jonelay/chibi-ecen-bldc/design-source/simulation/LT3840_DC1909A_TA01A.asc

C1: cap; 1µ
C2: cap; 4.7µ
C3: cap; 1µ
C4: polcap; 112µ; V=63 Irms=4.8 Rser=0.011
C5: cap; 100p
C6: cap; 13.2µ; V=100 Irms=6.893 Rser=0.002
C7: cap; 2.2n
C8: cap; 44µ; V=6.3 Irms=0 Rser=0.0004 Lser=0
C9: cap; 1n; V=50 Rser=0.002
C10: cap; 10n
C11: cap; 2.2n; V=50 Rser=0.002
C12: cap; 1n; V=50 Rser=0.002
C13: polcap; 680µ; V=6.3 Irms=4.8 Rser=0.012 Lser=0 mfg="KEMET" pn="T510E687K006AS4115" type="Tantalum"
C14: polcap; 680µ; V=6.3 Rser=0.012 Lser=0
C16: cap; 10n
D1: diode
L1: ind; 2.2µ; Ipk=31.9 Rser=0.0023 Cpar=0
L2: ind; 33µ; Ipk=0.6 Rser=1.0922 Rpar=3108.6 Cpar=0 mfg="Coilcraft" pn="ME3220-333"
M1: nmos; BSC123N08NS3
M2: nmos; BSC042NE7NS3
R1: res; 105K
R2: res; 13K
R3: res; 1K
R4: res; 100K
R5: res; 2.5m
R6: res; 0.167
R7: res; 825K
R8: res; 12
R9: res; 12
R10: res; 499K
R12: res; 1Meg
R13: res; 1Meg
U2: LT3840
V1: voltage; 12
Named nets: 0, IN, OUT
.tran 2.5m startup
LT3840 - Wide Input Range Synchronous Regulator Controller with Accurate Current Limit
High Efficiency Synchronous Buck Converter
Input: 4.5V to 60V       Output: 3.3V @ 20A, Fsw = 150kHz
Note:
  If the simulation model is not found please update with the "Sync Release" command from the "Tools" menu.
  It remains the customer's responsibility to verify proper and reliable operation in the actual application.
  Component substitution and printed circuit board layout may significantly affect circuit performance or reliability.
  Contact your local sales representative for assistance. This circuit is distributed to customers only for use with LTC parts.
  Copyright © 2014 Linear Technology Inc. All rights reserved.
(150kHz)
