jonelay/chibi-ecen-bldc/(list of files, drawings)

Other design files:
design-source/xdx/pcb/Layout/LayoutDB.lyt
gerbers/Gerber/Board1.dsn
