jonelay/chibi-ecen-bldc/design-source/cubemx/chibibldc_v02.ioc

Mcu.UserName=STM32F405RGTx
PA0-WKUP.GPIO_Label=ADC_VOLT3
PA0-WKUP.Signal=ADCx_IN0
PA1.GPIO_Label=ADC_VOLT2
PA1.Signal=ADCx_IN1
PA10.GPIO_Label=H1
PA10.Signal=S_TIM1_CH3
PA11.GPIO_Label=USB_DM
PA11.Signal=USB_OTG_FS_DM
PA12.GPIO_Label=USB_DP
PA12.Signal=USB_OTG_FS_DP
PA13.GPIO_Label=SWDIO
PA13.Signal=SYS_JTMS-SWDIO
PA14.GPIO_Label=SWCLK
PA14.Signal=SYS_JTCK-SWCLK
PA2.GPIO_Label=ADC_VOLT1
PA2.Signal=ADCx_IN2
PA4.GPIO_Label=ADC_TEMP
PA4.Signal=ADCx_IN4
PA5.GPIO_Label=ADC_CURRENT2
PA5.Signal=ADCx_IN5
PA6.GPIO_Label=ADC_CURRENT1
PA6.Signal=ADCx_IN6
PA7.GPIO_Label=LED_RED
PA7.Signal=GPIO_Output
PA8.GPIO_Label=H3
PA8.Signal=S_TIM1_CH1
PA9.GPIO_Label=H2
PA9.Signal=S_TIM1_CH2
PB10.GPIO_Label=RX_SCL
PB10.Signal=USART3_TX
PB11.GPIO_Label=TX_SDA
PB11.Signal=USART3_RX
PB12.GPIO_Label=DC_CAL
PB12.Signal=GPIO_Output
PB13.GPIO_Label=L3
PB13.Signal=TIM1_CH1N
PB14.GPIO_Label=L2
PB14.Signal=TIM1_CH2N
PB15.GPIO_Label=L1
PB15.Signal=TIM1_CH3N
PB5.GPIO_Label=SERVO
PB5.Signal=GPIO_Analog
PB6.GPIO_Label=HALL1
PB6.Signal=S_TIM4_CH1
PB7.GPIO_Label=HALL2
PB7.Signal=S_TIM4_CH2
PB8.Signal=CAN1_RX
PB9.GPIO_Label=CAN_TX
PB9.Signal=CAN1_TX
PC0.Signal=ADCx_IN10
PC10.GPIO_Label=EN_GATE
PC10.Signal=GPIO_Output
PC11.GPIO_Label=HALL_3
PC11.Signal=GPIO_Input
PC12.GPIO_Label=FAULT
PC12.Signal=GPIO_Output
PC2.Signal=ADCx_IN12
PC3.Signal=GPIO_Input
PC5.GPIO_Label=ADC_EXT
PC5.Signal=GPIO_Output
PC6.GPIO_Label=TX_SDA
PC6.Signal=I2S2_MCK
PC7.GPIO_Label=RX_SCL
PC7.Signal=I2S3_MCK
PH0-OSC_IN.Signal=RCC_OSC_IN
PH1-OSC_OUT.Signal=RCC_OSC_OUT
