jonelay/chibi-ecen-bldc/(commit log)

2026-01-08 Initial commit: Chibi-ECEN-BLDC hardware project
    [Board1.dsn, LayoutDB.lyt, bom.csv, bom.ods]
2026-01-08 Add board photographs to README
2026-01-08 Update README.md
    Made readme format more consistent with chibi-ecen-bms sister project
